B45i/Tiny-PoV/(commit log)

2021-06-21 small memory footprint
2021-06-28 gerber file
2021-06-29 file name case fix 1
2021-06-29 image case issue fix 2
2021-06-29 arduino-as-isp.png name fix
2021-06-29 battery name correction
2021-06-29 PCB Link
